MakeMagazinDE/Hydrokultur/Platinenlayout/Layout Hauptplatine.png

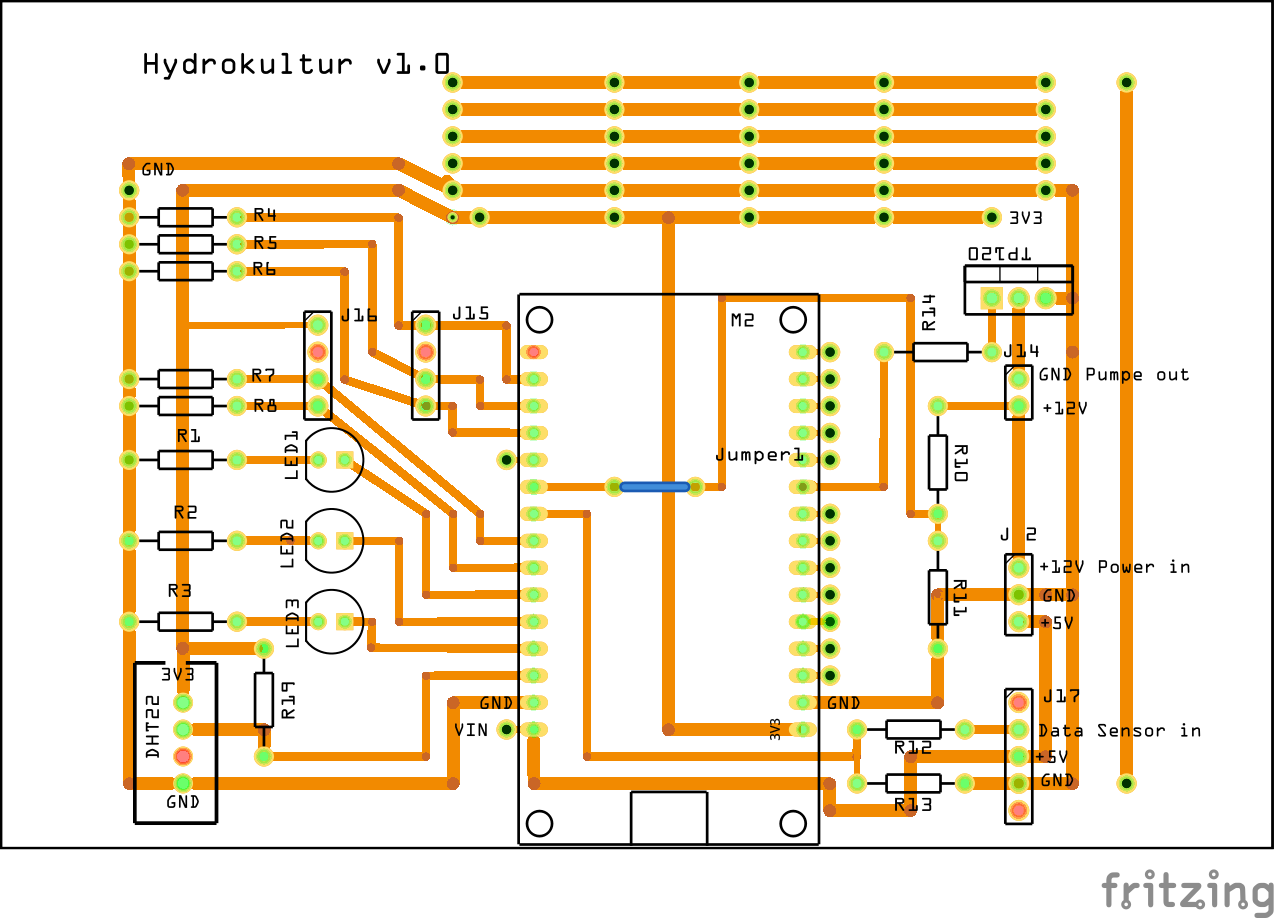
Platinenlayout/Layout Hauptplatine.png
