MakeMagazinDE/Hydrokultur/Platinenlayout/Layout Lochrasterplatine.png

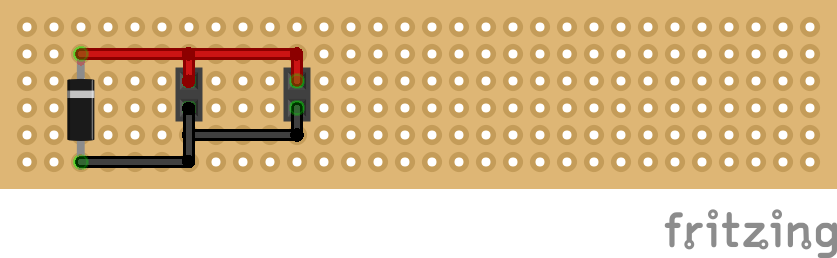
Platinenlayout/Layout Lochrasterplatine.png
