MakeMagazinDE/Hydrokultur/Materialliste.md

# Hydrokulturanlage

## Materialliste
- [ ] 2× HT Rohr 2m, DN 75
- [ ] 4× HT Bogen DN 75, 45°
- [ ] 1× HT Bogen DN 75, 87°
- [ ] 1× HT Muffenstopfen DN 75
- [ ] 1× HT Muffenstopfen DN 110
- [ ] 1× HT Reduzierung DN 110/75
- [ ] 1× HT Muffe DN 110
- [ ] 4× HT-Schelle DN 75
- [ ] 1× HT-Schelle DN 110
- [ ] 4m Gartenschlauch
- [ ] 4× Schlauchverbinder
- [ ] 4× Schlauchschellen Edelstahl
- [ ] 2× Schlauchverschraubung ¾″AG
- [ ] 1× Regentonnenanschluss ½″IG, ¾″AG
- [ ] 1× Regentonnenanschluss ¾″IG, 1″AG
- [ ] 3× Hahnanschluss ¾″IG
- [ ] 1× Hahnanschluss 1″IG
- [ ] 1× Saugkorb ½″AG
- [ ] 1× Saugkorb ¾″AG
- [ ] 1× Verschraubung (¾″IG) für Schlauchanschluß
- [ ] 5kg Aquariensand
- [ ] 5kg Aquarienkies 2-4 mm
- [ ] 5kg Auarienkies 5-8 mm
- [ ] 1× Stapelbox 64 l
- [ ] 1× Stapelbox 27 l
- [ ] 2× O-Ringe 60mm × 70mm × 5mm

### Elektronische Bauteile:
- [ ] 1× Rot (633nm) LED
- [ ] 1× Gelb (595nm) LED
- [ ] 1× Grün (565nm) LED
- [ ] 1× Esp32 DevKit v1 
- [ ] 3× 100Ω Widerstand (R1-R3)
- [ ] 5× 1kΩ Widerstand (R4-R8)
- [ ] 2× 47kΩ Widerstand (R10, R19)
- [ ] 3× 10kΩ Widerstand (R11-R13)
- [ ] 1× 470Ω Widerstand (R14)
- [ ] 1× Luftfeuchtigkeits- Temperatursensor DHT22
- [ ] 1× TIP120, NPN Transistor 60V 5A, TO220 M
- [ ] 1× Mini DC-DC Spannungsregler MP1584
- [ ] 1× Micro Mini Stecker 2.54mm 2 3 4 5-Pin CRIMP Set
- [ ] 1× Lochrasterplatine 2x8cm
- [ ] 1× Diode
- [ ] 1× 40 Pin 2,54 mm Buchsenleiste Female Pin Header einreihig
- [ ] 1× Tangda DC 12V Wasserpumpe
- [ ] 1× Solarladeregler für Solarpanels bis max. 53 W
- [ ] 1× Solarpanel 12 V, 10 W
- [ ] 1× Autobatterie 40Ah
- [ ] 1× Platine, Epoxyd, einseitig, 120 x 80 mm
- [ ] 1× Navigationsschalter 5 Richtungen
- [ ] 5m Lautsprecherkabel zum Anschluss der Solarzelle/Batterie
- [ ] 8× Crimp Kabelschuhe und Flachstecker
