MakeMagazinDE/Hydrokultur/Platinenlayout/Hydro Esp2_etch_copper_bottom.pdf

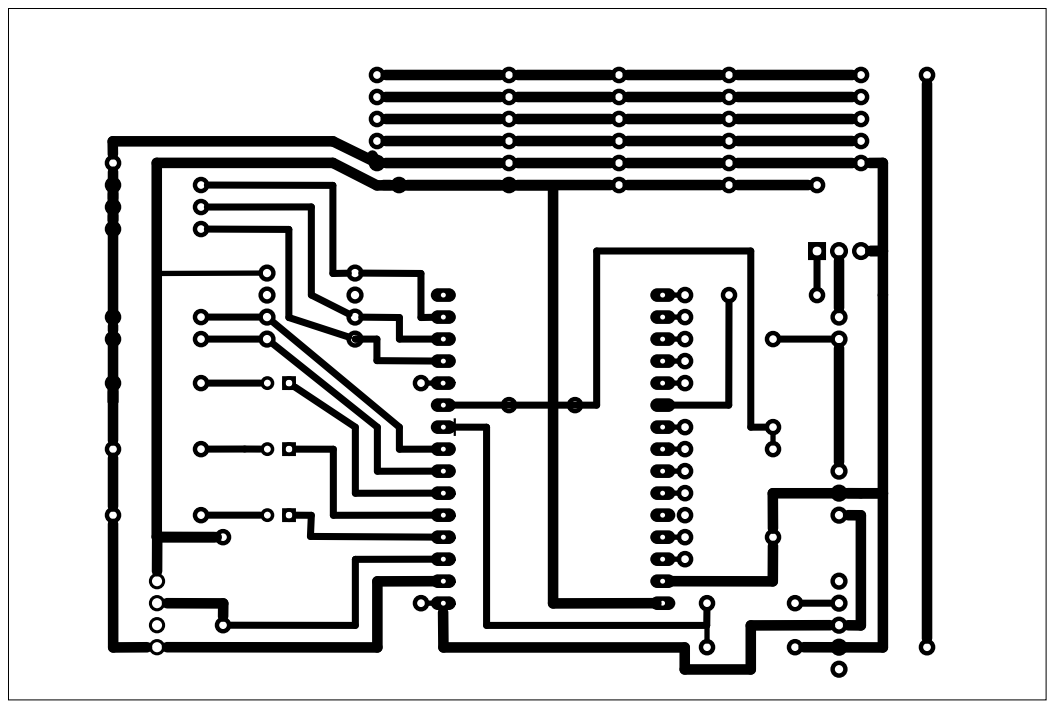
[picture p4: page 1]
