MakeMagazinDE/Hydrokultur/Platinenlayout/Hydro Esp2_etch_copper_bottom_mirror.pdf

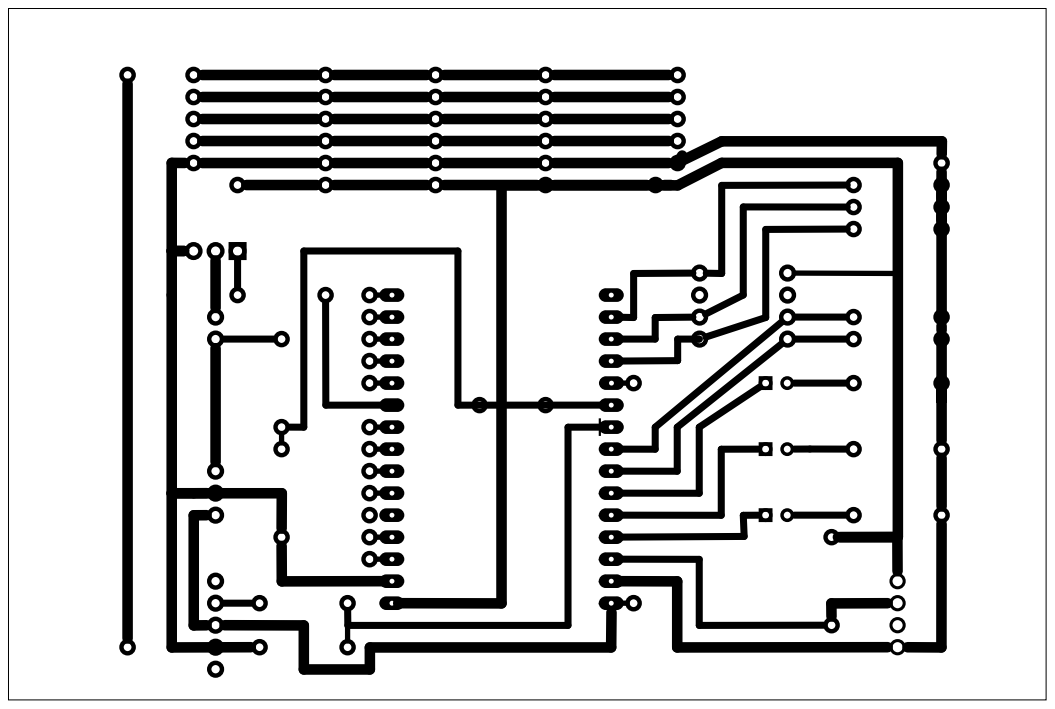
[picture p5: page 1]
