MakeMagazinDE/Hydrokultur/Platinenlayout/Hydro Esp2_etch_silk_top.pdf

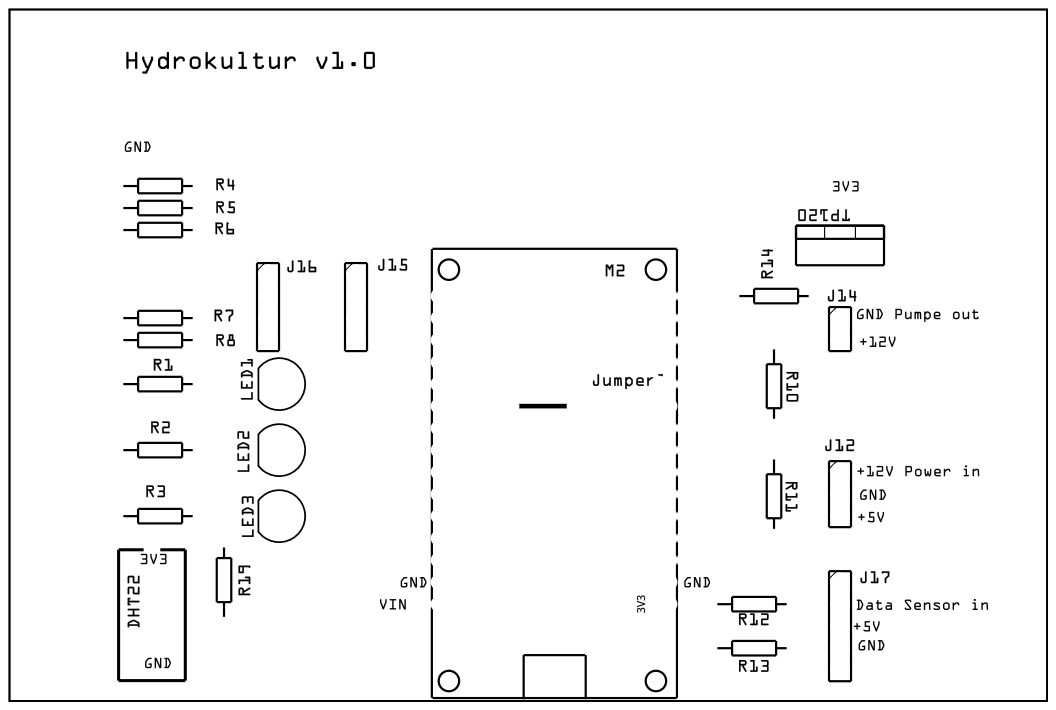
[picture p6: page 1]
