MakeMagazinDE/Hydrokultur/Platinenlayout/Hydro Esp2_etch_silk_top_mirror.pdf

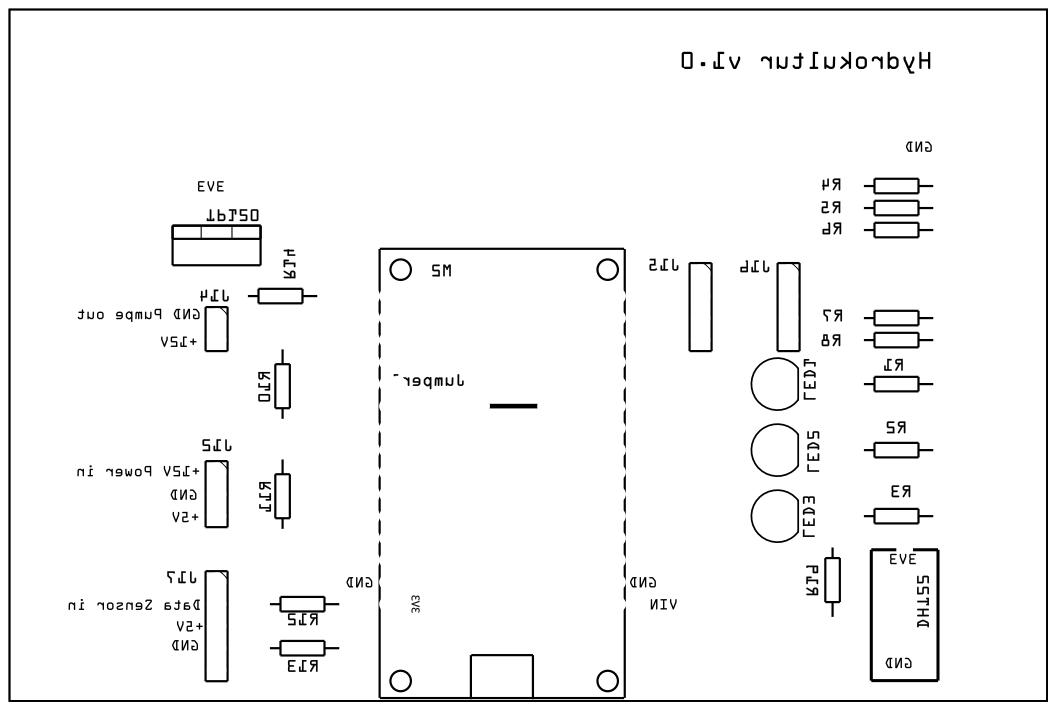
[picture p7: page 1]
