MakeMagazinDE/Hydrokultur/(threads)

Thread 1 (2021-09-29):

missing 3d designs for cups and waterlevel

Candymirror, 2021-09-29:
I bought the dutch version of this issue (make 4/2021). It refers to make-magazin.de/xj99 but there is nothing to be found. From de german article I found this github page and axpected to find the 3d printables.

MakeMagazinDE, 2021-09-29:
Hi Candymirror,

make-magazin.de/xj99 is a redirect to https://www.heise.de/select/make/2021/1/softlinks/xj99
There you'll find the link to https://www.thingiverse.com/thing:4735763 and the printables.

All the best
Helga/hch

Closed 2021-09-29.

Thread 2 (2022-02-22):

Verständnis Intervall

bjoerns1983, 2022-02-22:
Guten Tag,
habe ich den Code richtig verstanden das beim Temperaturabhängigen schalten der Pumpe diese bei Tempertauren über 30°C jede halbe Stunde für 25sek eingeschaltet wird und im anderen extremfall unter 10°C all 4 Stunden?

Wir waren denn die Ergebnisse mit dieser Bewässerungstechnik. Wenn man sich zu NFT Hdyroponik Systemen beschäftigt bekommt man auf die Frage in welchem Intervall man bewässern soll bzw. wie lange zig verschiedene Antworten.
